uwrobotics/MarsRoverElectricalKiCad/README.md

# Getting Started

Please follow the following step to create a project from template, step by step and complete the project
