uwrobotics/MarsRoverElectricalKiCad/projects/LM5143_Buck/LM5143_BOM.xlsx

Part/Label | Value | Qty. | Price (USD or CAD) | Sum (CAD) | Link
Buck Controller |  |  |  |  |  |  | USD to CAD Conversion Rate | 1.37
LM5143QRHARQ1 |  | 1 | 3.72 | 5.10 | https://www.lcsc.com/product-detail/C5219258.html
Capacitor In
EKYC101ELL331MK25S | 330uF | 4 | 1.92 | 7.68 | https://www.digikey.ca/en/products/detail/chemi-con/EKYC101ELL331MK25S/26120648
CL32B475KCJZ4NE | 4.7uF | 8 | 0.69 | 5.52 | https://www.digikey.ca/en/products/detail/samsung-electro-mechanics/CL32B475KCJZ4NE/27519552
CL10B104KC8NNNC | 100nF | 0.32 | 0.33 | 0.14 | https://www.lcsc.com/product-detail/C15725.html | *16 out of 50
CL10B103KC8NNNC | 10nF | 0.05 | 0.63 | 0.04 | https://www.lcsc.com/product-detail/C84709.html | *5 out of 100
Capacitor Out
RPF0811101M050K | 100uF | 2 | 1.46 | 2.92 | https://www.digikey.ca/en/products/detail/kyocera-avx/RPF0811101M050K/20096773
CL32B106KBJNNNE | 10uF | 5 | 0.17 | 1.16 | https://www.lcsc.com/product-detail/C138687.html
CL10B104KC8NNNC | 100nF | Tallied Above (2x)
GanFET + Driver
IGC025S08S1XTMA1 |  | 4 | 6.62 | 26.48 | https://www.digikey.ca/en/products/detail/infineon-technologies/IGC025S08S1XTMA1/25902269
LM5113QDPRRQ1 |  | 2 | 6.79 | 13.58 | https://www.digikey.ca/en/products/detail/texas-instruments/LM5113QDPRRQ1/7034938
RC0603FR-071KL | 1k | 0.04 | 0.13 | 0.01 | https://www.lcsc.com/product-detail/C22548.html | *4 out of 100
CL10C220JB8NNNC | 22pF | 0.04 | 0.45 | 0.02 | https://www.lcsc.com/product-detail/C1653.html | *4 out of 100
CL10B105KA8NNNC | 1uF | 0.12 | 0.32 | 0.05 | https://www.lcsc.com/product-detail/C29936.html | *6 out of 50
BAT46JFILM |  | 0.4 | 0.71 | 0.39 | https://www.lcsc.com/product-detail/C111205.html | *4 out of 10
RC0603FR-07100RL | 100 | 0.02 | 0.13 | 0.003562 | https://www.lcsc.com/product-detail/C105588.html | *2 out of 100
CL10B104KC8NNNC | 100nF | Tallied Above (2x)
RC0603FR-070RL | 0 | 0.08 | 0.12 | 0.01 | https://www.lcsc.com/product-detail/C95177.html | *8 out of 100
LDOs
AP7387-50FDC-7 |  | 1 | 0.75 | 0.75 | https://www.digikey.ca/en/products/detail/diodes-incorporated/AP7387-50FDC-7/17874785
CL10B105KA8NNNC | 1uF | Tallied Above (3x)
CL32B106KBJNNNE | 10uF | Tallied Above (1x)
TLV74033PDBVR |  | 0.1 | 0.51 | 0.07 | https://www.lcsc.com/product-detail/C3743587.html | *1 out of 10
RT0603FRE0710KL | 10k | 0.04 | 0.52 | 0.03 | https://www.lcsc.com/product-detail/C469659.html | *2 out of 50
Inductor
CPQ2620H-100M | 10uH | 2 | 2.99 | 8.19 | https://www.lcsc.com/product-detail/C41347719.html
Shunt Resistors
ASR-K-3-2.2F | 2.2m | 0.4 | 1.35 | 0.74 | https://www.lcsc.com/product-detail/C6075476.html | *2 out of 5
PCSR2512BR005M6 | 5m | 4 | 3.13 | 17.15 | https://www.lcsc.com/product-detail/C48982662.html
Heat Sink
HSB35-272725 |  | 1 | 2.95 | 2.95 | https://www.digikey.ca/en/products/detail/same-sky-formerly-cui-devices/HSB35-272725/22535724
Heat Sink Tape |  | 0.01 | 6.94 | 0.07 | https://www.digikey.ca/en/products/detail/adafruit-industries-llc/1468/7241459
Compensation
RT0603FRE0712KL | 12k | 0.02 | 0.52 | 0.01 | https://www.lcsc.com/product-detail/C136933.html | *1 out of 50
GRM1885C1H562JA01D | 5.6nF | 0.02 | 0.74 | 0.02 | https://www.lcsc.com/product-detail/C440183.html | *1 out of 50
CL10C121JB8NNNC | 120pF | 0.02 | 0.55 | 0.02 | https://www.lcsc.com/product-detail/C18438.html | *1 out of 50
Others
CL10B104KC8NNNC | 100nF | Tallied Above (3x)
CL21B225KAFNNNE | 2.2uF | 0.3 | 0.15 | 0.06 | https://www.lcsc.com/product-detail/C19110.html | *3 out of 10
CL10B474KA8NNNC | 470nF | 0.02 | 0.71 | 0.02 | https://www.lcsc.com/product-detail/C1623.html | *2 out of 100
CL10B103KC8NNNC | 10nF | Tallied Above (1x)
RT0603FRE07100KL | 100k | 0.02 | 0.55 | 0.02 | https://www.lcsc.com/product-detail/C728638.html | *1 out of 50
RT0603FRE07390KL | 390k | 0.02 | 0.54 | 0.01 | https://www.lcsc.com/product-detail/C863775.html | *1 out of 50
RT0603FRE0710KL | 10k | Tallied Above (1x)
B18W1NG--20C000114U1930 |  | 1 | 0.23 | 0.23 | https://www.digikey.ca/en/products/detail/harvatek-corporation/B18W1NG-20C000114U1930/13588743
RT0603FRE073K3L | 3.3k | 0.08 | 0.52 | 0.06 | https://www.lcsc.com/product-detail/C863782.html | *4 out of 50
RH-5001 |  | 0.8 | 0.39 | 0.43 | https://www.lcsc.com/product-detail/C5199801.html | *4 out of 5
Telemetry
INA226AIDGSR |  | 1 | 0.67 | 0.92 | https://www.lcsc.com/product-detail/C49851.html
CL10B105KA8NNNC | 1uF | Tallied Above (1x)
RT0603FRE073K3L | 3.3k | Tallied Above (3x)
RT0603BRD0710RL | 10 | 0.4 | 0.94 | 0.52 | https://www.lcsc.com/product-detail/C861082.html | *8 out of 20
CL10B104KC8NNNC | 100nF | Tallied Above (1x)
Switch
SLW-1478144-5A-S-D |  | 2 | 0.68 | 1.36 | https://www.digikey.ca/en/products/detail/same-sky-formerly-cui-devices/SLW-1478144-5A-S-D/24399221
SLW-865144-2A-N-SMT-TR |  | 2 | 0.81 | 1.62 | https://www.digikey.ca/en/products/detail/same-sky-formerly-cui-devices/SLW-865144-2A-N-SMT-TR/24399296
Connectors
XT60PW-M |  | 1 | 0.47 | 0.64 | https://www.lcsc.com/product-detail/C98732.html
XT60PW-F |  | 1 | 0.50 | 0.69 | https://www.lcsc.com/product-detail/C428722.html
SM04B-GHS-TB |  | 0.4 | 1.27 | 0.70 | https://www.lcsc.com/product-detail/C189895.html | *2 out of 5
 |  |  | Total Cost: | 100.38
