uwrobotics/MarsRoverElectricalKiCad/projects/LM5143_Buck/LM5143_Buck.kicad_pcb

## KiCad design projects/LM5143_Buck/LM5143_Buck.kicad_pcb (2026-03-19)

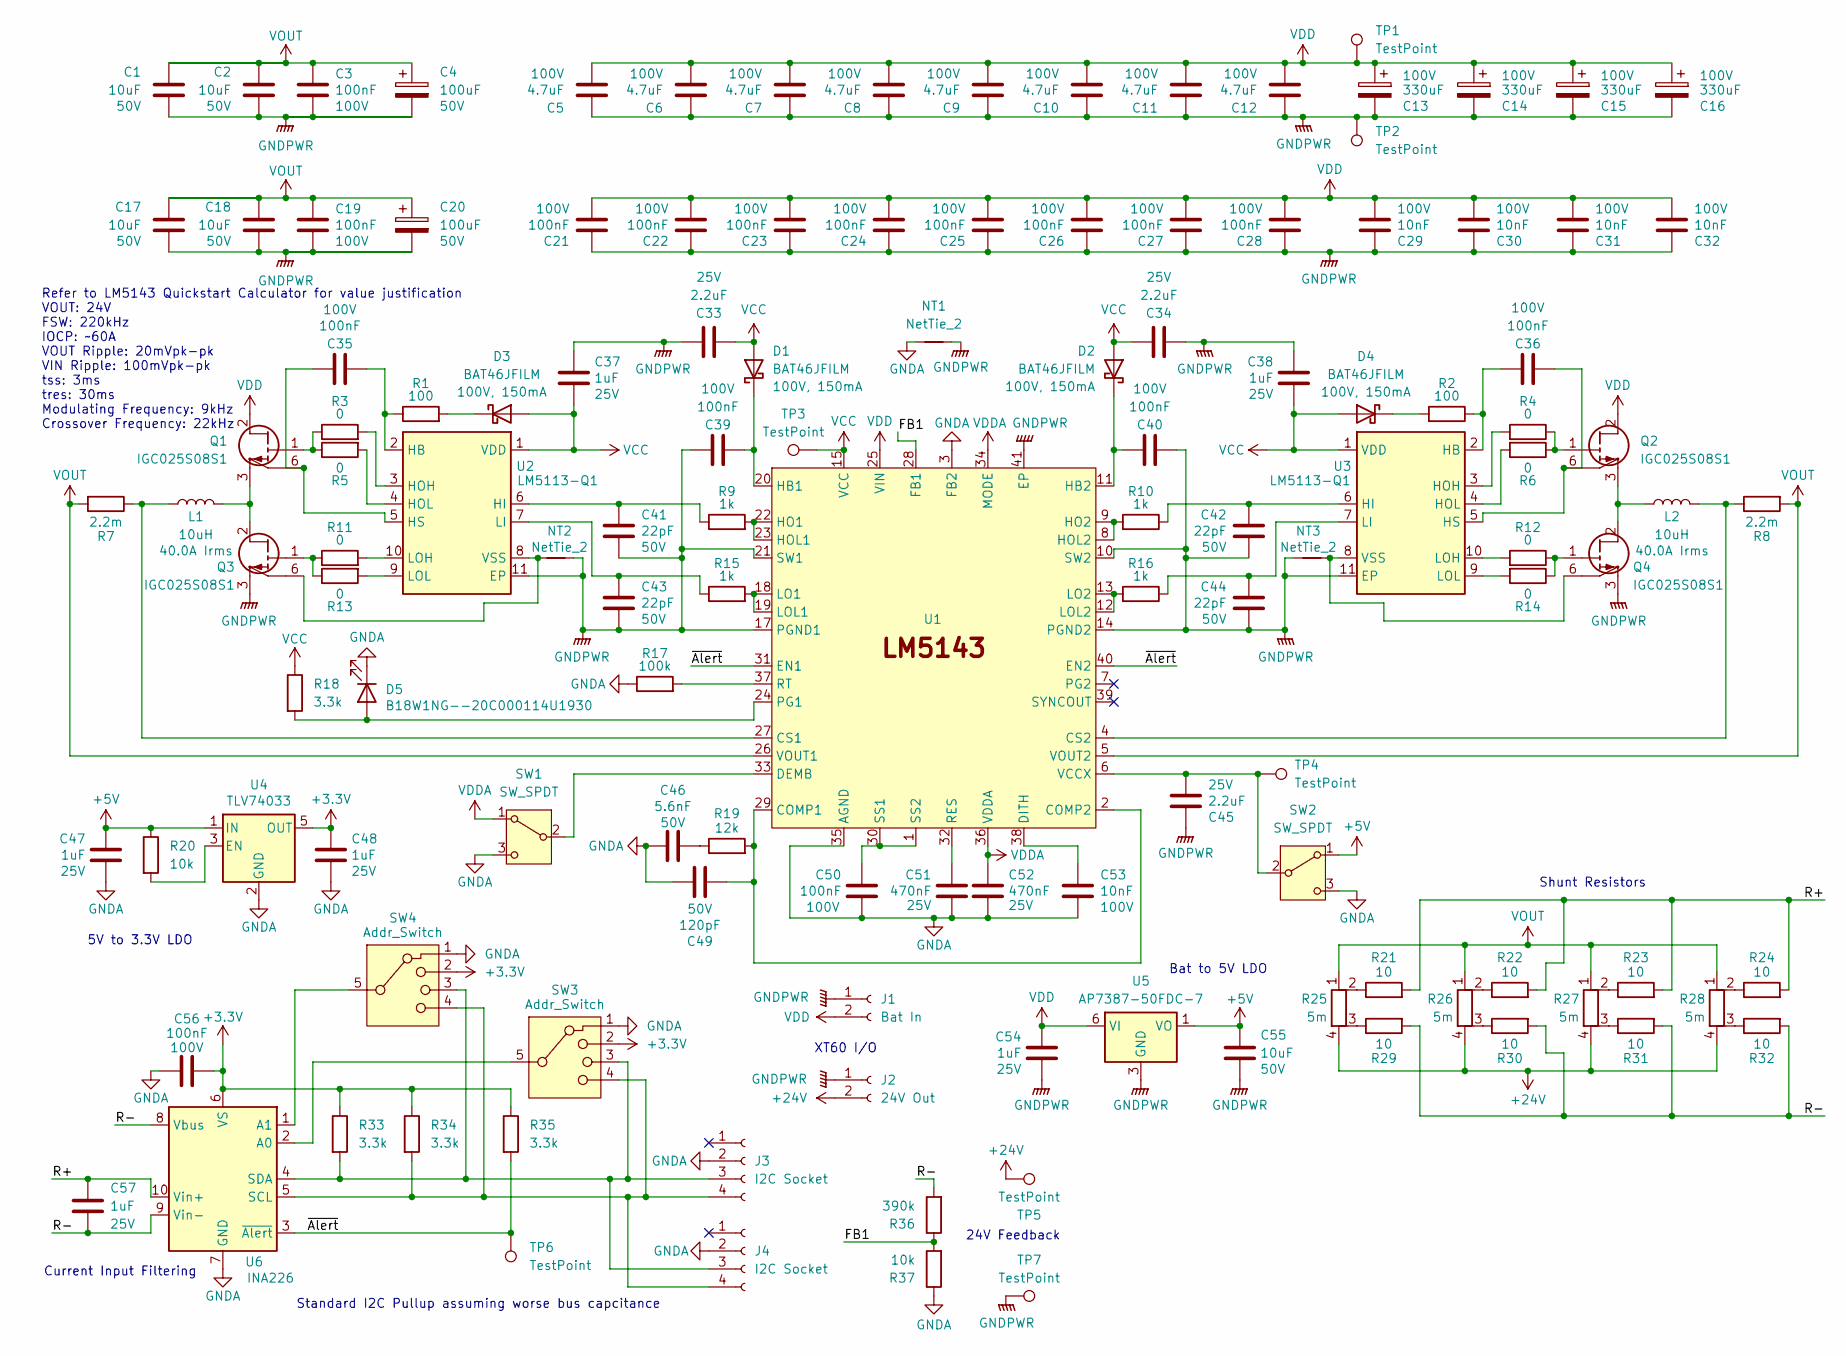
[picture p1: schematic LM5143_Buck.kicad_sch, LM5143 Buck]

Parts:
C1, C2, C17, C18, C55: 10uF; C_1210_3225Metric; Voltage 50V
C3, C19, C21, C22, C23, C24, C25, C26, C27, C28, C35, C36, C39, C40, C50, C56: 100nF; C_0603_1608Metric; Voltage 100V
C4, C20: 100uF; CP_Radial_D8.0mm_P3.50mm; Voltage 50V
C5, C6, C7, C8, C9, C10, C11, C12: 4.7uF; C_1210_3225Metric; Voltage 100V
C13, C14, C15, C16: 330uF; CP_Radial_D12.5mm_P5.00mm; Voltage 100V
C29, C30, C31, C32, C53: 10nF; C_0603_1608Metric; Voltage 100V
C33, C34, C45: 2.2uF; C_0805_2012Metric; Voltage 25V
C37, C38, C47, C48, C54, C57: 1uF; C_0603_1608Metric; Voltage 25V
C41, C42, C43, C44: 22pF; C_0603_1608Metric; Voltage 50V
C46: 5.6nF; C_0603_1608Metric; Voltage 50V
C49: 120pF; C_0603_1608Metric; Voltage 50V
C51, C52: 470nF; C_0603_1608Metric; Voltage 25V
D1, D2, D3, D4: BAT46JFILM; D_SOD-323_Alt
D5: B18W1NG--20C000114U1930; LED_0603_1608Metric
J1: Bat In; XT60PW
J2: 24V Out; XT60PW
J3, J4: I2C Socket; JST_GH_SM04B-GHS-TB_1x04-1MP_P1.25mm_Horizontal
L1, L2: 10uH; CPQ2620H
NT1, NT2, NT3: NetTie_2; NetTie-2_SMD_Pad0.25mm
Q1, Q2, Q3, Q4: IGC025S08S1; PG‑TSON‑6
R1, R2: 100; R_0603_1608Metric
R3, R4, R5, R6, R11, R12, R13, R14: 0; R_0603_1608Metric
R7, R8: 2.2m; ASR2512
R9, R10, R15, R16: 1k; R_0603_1608Metric
R17: 100k; R_0603_1608Metric
R18, R33, R34, R35: 3.3k; R_0603_1608Metric
R19: 12k; R_0603_1608Metric
R20, R37: 10k; R_0603_1608Metric
R21, R22, R23, R24, R29, R30, R31, R32: 10; R_0603_1608Metric
R25, R26, R27, R28: 5m; PCSR2512
R36: 390k; R_0603_1608Metric
SW1, SW2: SW_SPDT; SLW-865144-2A-N-SMT-TR
SW3, SW4: Addr_Switch; SLW-1478144-5A-S-D
TP1, TP2, TP5, TP7: TestPoint; TestPoint_Keystone_5000-5004_Miniature
TP3, TP4, TP6: TestPoint; TestPoint_Pad_D2.0mm
U1: Texas_VQFN-40-1EP_6x6mm_P0.5mm_EP3.3x3.3mm_ThermalVias
U2, U3: LM5113-Q1; WSON-10-1EP_4x4mm_P0.8mm_EP2.6x3mm_ThermalVias
U4: TLV74033; SOT-23-5
U5: AP7387-50FDC-7; DFN-6-1EP_2x2mm_P0.65mm_EP1.01x1.7mm
U6: INA226; VSSOP-10_3x3mm_P0.5mm

Connections:
+3.3V: C48.1, C56.2, R33.1, R34.1, R35.1, SW3.2, SW4.2, U4.5 (OUT), U6.6 (VS)
+5V: C47.1, C55.1, R20.1, SW2.1 (A), U4.1 (IN), U5.1 (VO)
+24V: J2.2, R25.4, R26.4, R27.4, R28.4, TP5.1
/FB1: R36.1, R37.2, U1.28 (FB1)
/R+: C57.1, R21.2, R22.2, R23.2, R24.2, U6.10 (Vin+)
/R-: C57.2, R29.2, R30.2, R31.2, R32.2, R36.2, U6.8 (Vbus), U6.9 (Vin-)
/~Alert: R35.2, TP6.1, U1.31 (EN1), U1.40 (EN2), U6.3 (~Alert)
GNDA: C46.1, C47.2, C48.2, C49.1, C50.2, C51.2, C52.2, C53.2, C56.1, D5.1 (K), J3.2, J4.2, NT1.1, R17.1, R37.1, SW1.3 (C), SW2.3 (C), SW3.1, SW4.1, U1.3 (FB2), U1.35 (AGND), U4.2 (GND), U6.7 (GND)
GNDPWR: C1.2, C2.2, C3.2, C4.2, C5.1, C6.1, C7.1, C8.1, C9.1, C10.1, C11.1, C12.1, C13.2, C14.2, C15.2, C16.2, C17.2, C18.2, C19.2, C20.2, C21.1, C22.1, C23.1, C24.1, C25.1, C26.1, C27.1, C28.1, C29.1, C30.1, C31.1, C32.1, C33.1, C34.1, C37.1, C38.1, C39.1, C40.1, C41.2, C42.2, C43.2, C44.2, C45.1, C54.2, C55.2, J1.1, J2.1, NT1.2, NT2.2, NT3.2, Q3.3 (S), Q3.5 (S), Q4.3 (S), Q4.5 (S), TP2.1, TP7.1, U1.10 (SW2), U1.14 (PGND2), U1.17 (PGND1), U1.21 (SW1), U1.41 (EP), U2.11 (EP), U3.11 (EP), U5.2 (GND), U5.3 (GND), U5.4 (GND), U5.5 (GND), U5.7 (GND)
unnamed: C46.2, R19.1
unnamed: C39.2, D1.1 (K), U1.20 (HB1)
unnamed: C40.2, D2.1 (K), U1.11 (HB2)
unnamed: D3.1 (K), R1.2
unnamed: D4.1 (K), R2.2
unnamed: D5.2 (A), R18.2, U1.24 (PG1)
unnamed: J3.3, J4.3, R33.2, SW3.3, SW4.3, U6.4 (SDA)
unnamed: J3.4, J4.4, R34.2, SW3.4, SW4.4, U6.5 (SCL)
unnamed: L1.2, Q1.3 (S), Q1.5 (S), Q3.2 (D), Q3.4 (D)
unnamed: L2.1, Q2.3 (S), Q2.5 (S), Q4.2 (D), Q4.4 (D)
unnamed: Q1.1 (G), R3.1, R5.1
unnamed: C35.1, Q1.6 (SS), U2.5 (HS)
unnamed: Q2.1 (G), R4.1, R6.1
unnamed: C36.1, Q2.6 (SS), U3.5 (HS)
unnamed: Q3.1 (G), R11.1, R13.1
unnamed: NT2.1, Q3.6 (SS), U2.8 (VSS)
unnamed: Q4.1 (G), R12.1, R14.1
unnamed: NT3.1, Q4.6 (SS), U3.8 (VSS)
unnamed: R21.1, R25.2
unnamed: R22.1, R26.2
unnamed: R23.1, R27.2
unnamed: R24.1, R28.2
unnamed: R25.3, R29.1
unnamed: R26.3, R30.1
unnamed: R27.3, R31.1
unnamed: R28.3, R32.1
unnamed: SW1.2 (B), U1.33 (DEMB)
unnamed: C45.2, SW2.2 (B), TP4.1, U1.6 (VCCX)
unnamed: C49.2, R19.2, U1.2 (COMP2), U1.29 (COMP1)
unnamed: L1.1, R7.1, U1.27 (CS1)
unnamed: L2.2, R8.1, U1.4 (CS2)
unnamed: C53.1, U1.38 (DITH)
unnamed: R9.2, U1.22 (HO1), U1.23 (HOL1)
unnamed: R10.2, U1.8 (HOL2), U1.9 (HO2)
unnamed: R15.2, U1.18 (LO1), U1.19 (LOL1)
unnamed: R16.2, U1.12 (LOL2), U1.13 (LO2)
unnamed: C51.1, U1.32 (RES)
unnamed: R17.2, U1.37 (RT)
unnamed: C50.1, U1.1 (SS2), U1.30 (SS1)
unnamed: C35.2, R1.1, U2.2 (HB)
unnamed: C41.1, R9.1, U2.6 (HI)
unnamed: R3.2, U2.3 (HOH)
unnamed: R5.2, U2.4 (HOL)
unnamed: C43.1, R15.1, U2.7 (LI)
unnamed: R11.2, U2.10 (LOH)
unnamed: R13.2, U2.9 (LOL)
unnamed: C36.2, R2.1, U3.2 (HB)
unnamed: C42.1, R10.1, U3.6 (HI)
unnamed: R4.2, U3.3 (HOH)
unnamed: R6.2, U3.4 (HOL)
unnamed: C44.1, R16.1, U3.7 (LI)
unnamed: R12.2, U3.10 (LOH)
unnamed: R14.2, U3.9 (LOL)
unnamed: R20.2, U4.3 (EN)
unnamed: SW3.5, U6.2 (A0)
unnamed: SW4.5, U6.1 (A1)
VCC: C33.2, C34.2, C37.2, C38.2, D1.2 (A), D2.2 (A), D3.2 (A), D4.2 (A), R18.1, TP3.1, U1.15 (VCC), U1.16 (VCC), U2.1 (VDD), U3.1 (VDD)
VDD: C5.2, C6.2, C7.2, C8.2, C9.2, C10.2, C11.2, C12.2, C13.1, C14.1, C15.1, C16.1, C21.2, C22.2, C23.2, C24.2, C25.2, C26.2, C27.2, C28.2, C29.2, C30.2, C31.2, C32.2, C54.1, J1.2, Q1.2 (D), Q1.4 (D), Q2.2 (D), Q2.4 (D), TP1.1, U1.25 (VIN), U5.6 (VI)
VDDA: C52.1, SW1.1 (A), U1.34 (MODE), U1.36 (VDDA)
VOUT: C1.1, C2.1, C3.1, C4.1, C17.1, C18.1, C19.1, C20.1, R7.2, R8.2, R25.1, R26.1, R27.1, R28.1, U1.5 (VOUT2), U1.26 (VOUT1)

Notes on the sheet:
24V Feedback
Bat to 5V LDO
Refer to LM5143 Quickstart Calculator for value justification VOUT: 24V FSW: 220kHz IOCP: ~60A VOUT Ripple: 20mVpk-pk VIN Ripple: 100mVpk-pk tss: 3ms tres: 30ms Modulating Frequency: 9kHz Crossover Frequency: 22kHz
XT60 I/O
5V to 3.3V LDO
Current Input Filtering
Shunt Resistors
Standard I2C Pullup assuming worse bus capcitance

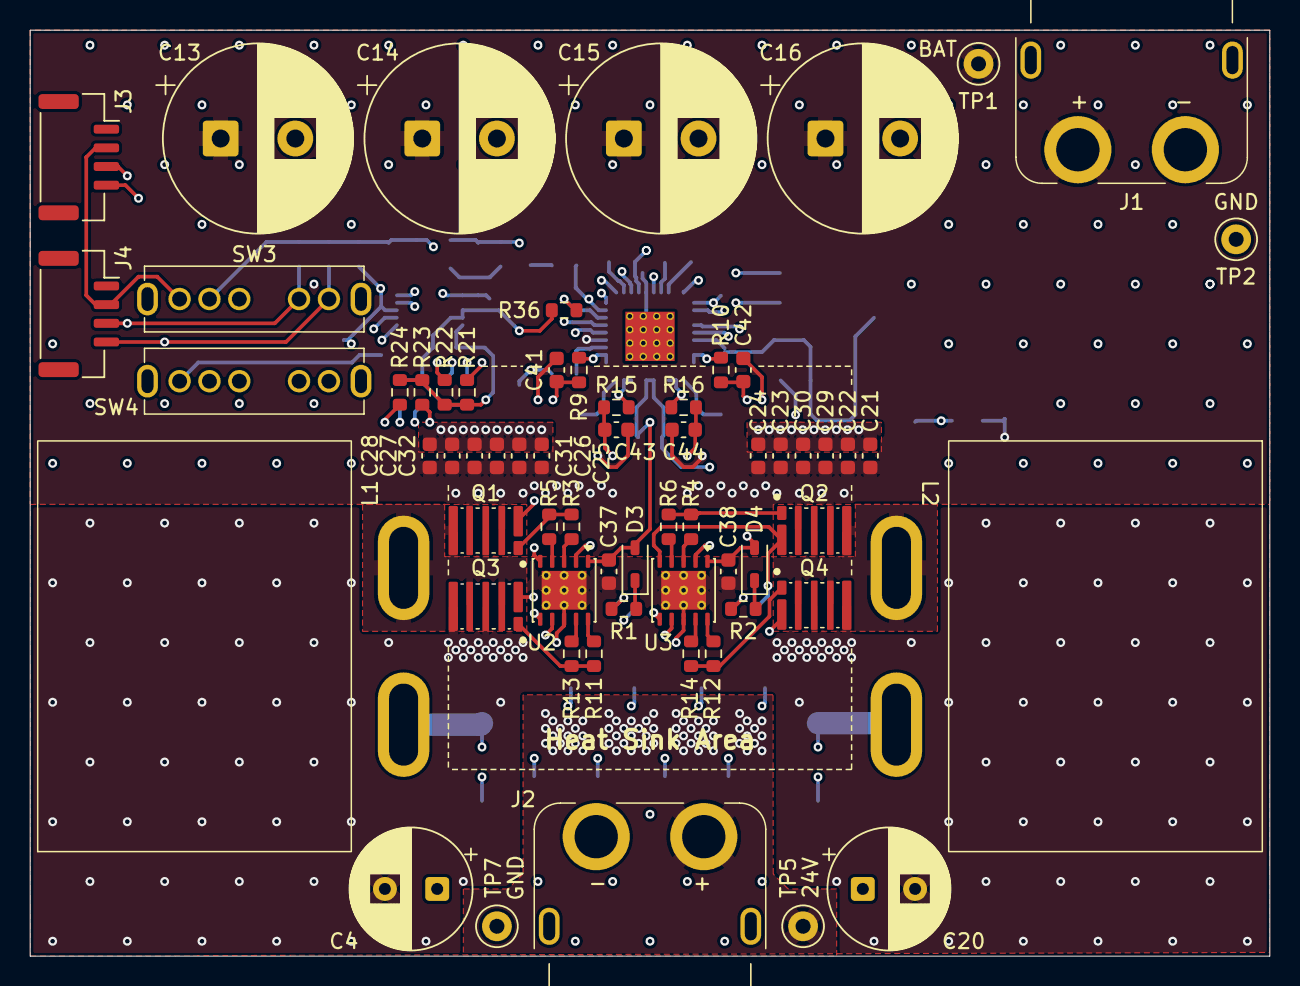
[picture p2: board LM5143_Buck.kicad_pcb from above]

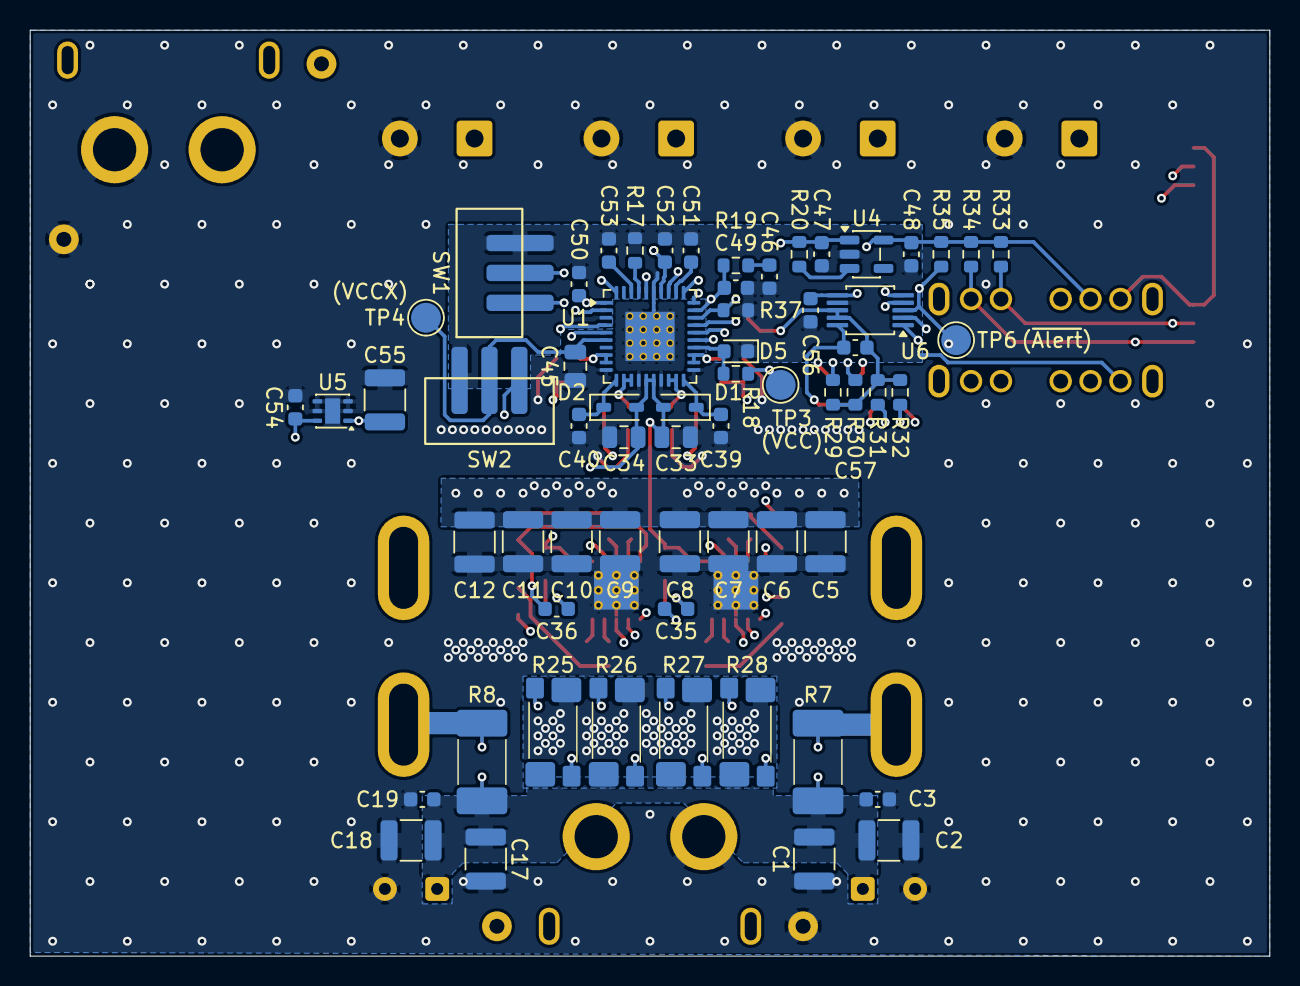
[picture p3: board LM5143_Buck.kicad_pcb from below]

Board: 4 copper layers, 83.0 x 62.0 mm, 129 parts (64 on the bottom side), 69 nets.
