uwrobotics/MarsRoverElectricalKiCad/projects/LM5143_Buck/BSR066A/BSR066A.kicad_pcb

## KiCad design projects/LM5143_Buck/BSR066A/BSR066A.kicad_pcb (2026-01-29)

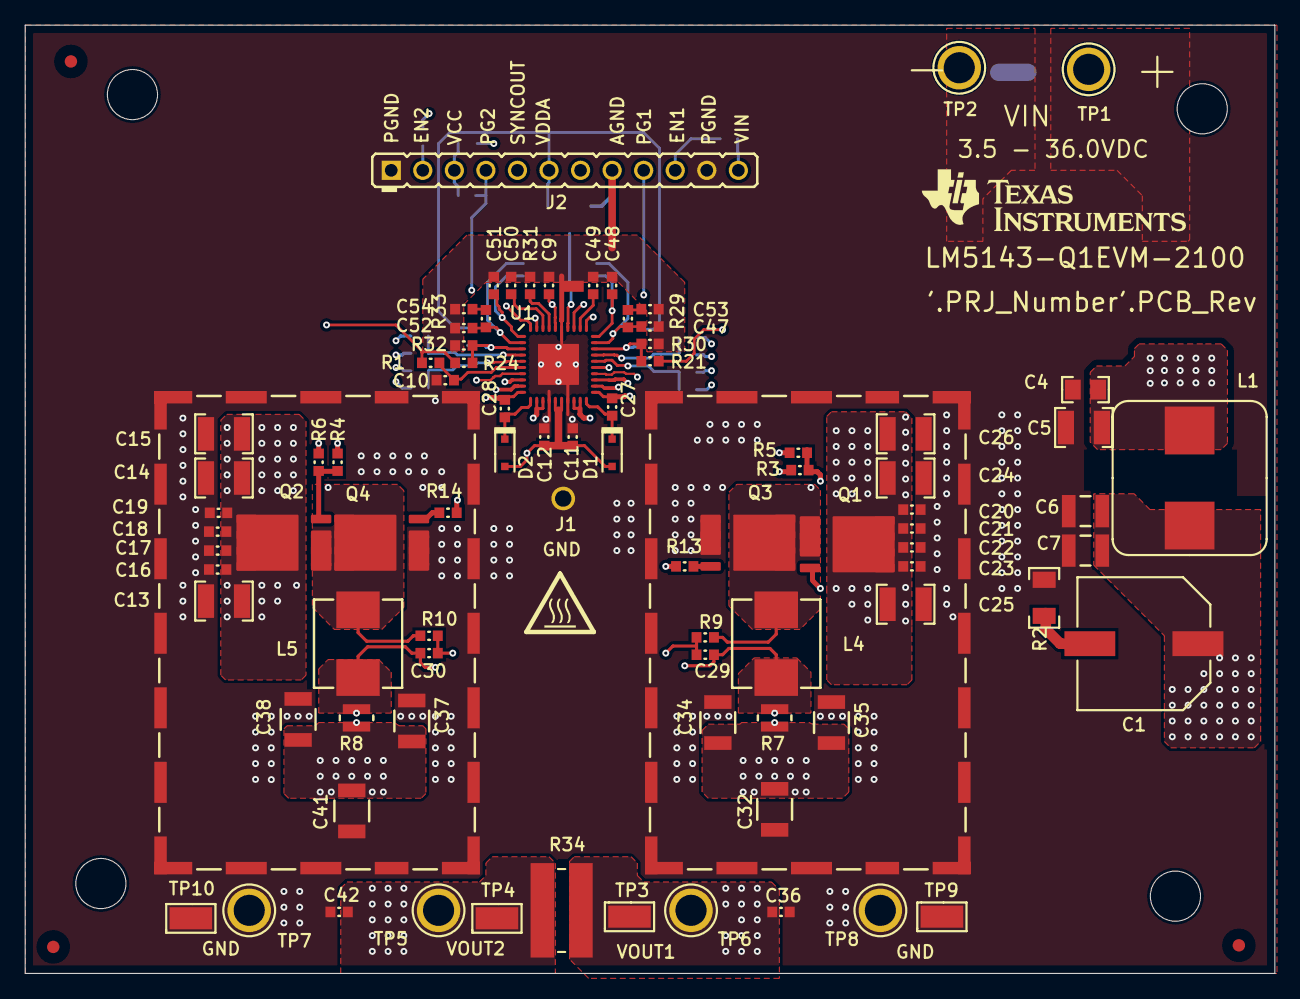
[picture p4: board BSR066A.kicad_pcb from above]

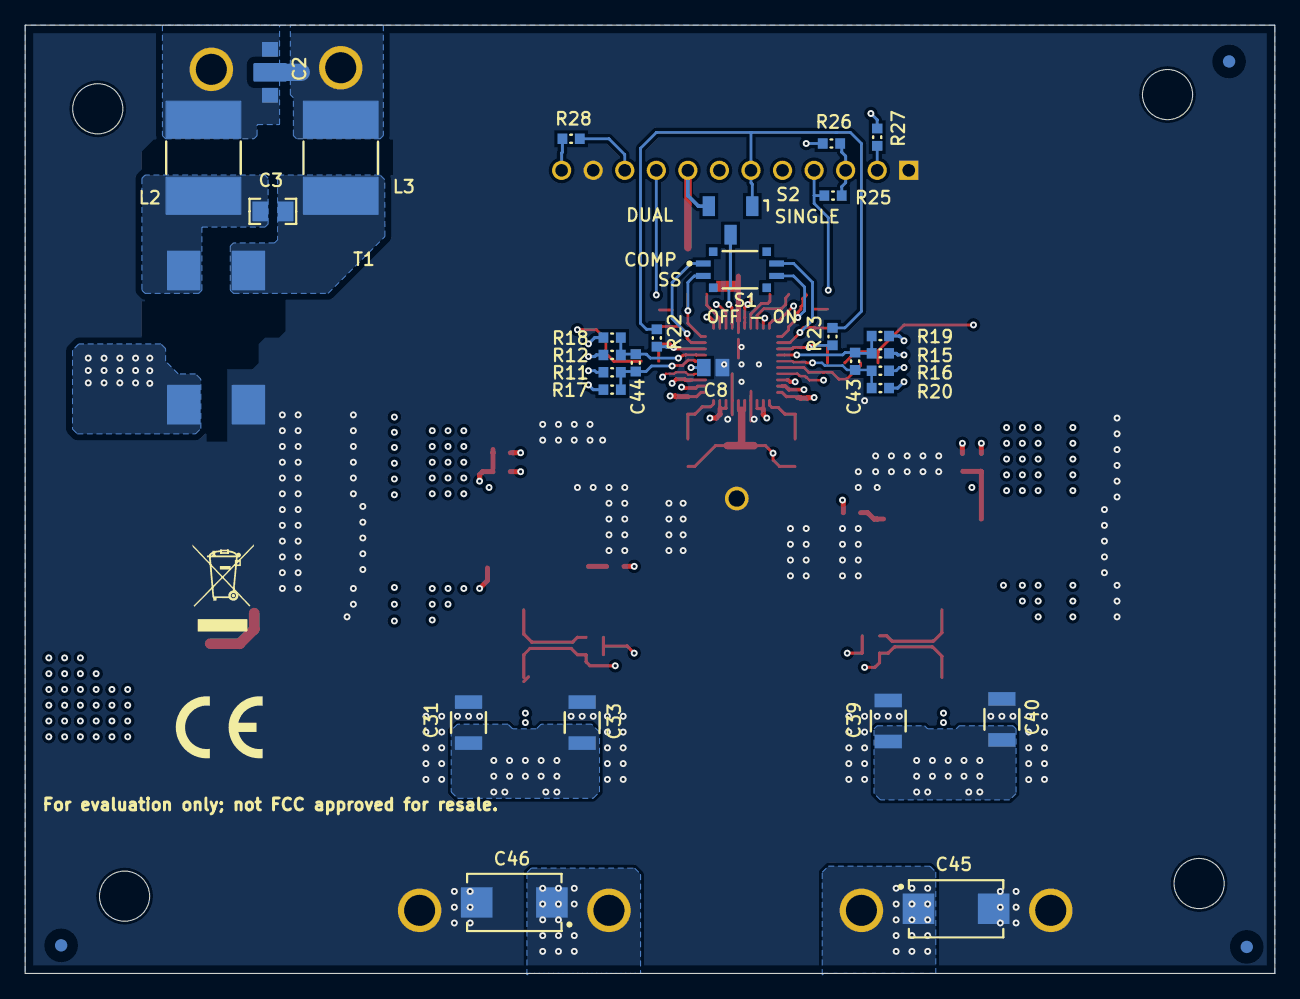
[picture p5: board BSR066A.kicad_pcb from below]

Board: 6 copper layers, 100.6 x 76.3 mm, 144 parts (40 on the bottom side), 54 nets.

Parts:
C1: EEE-FC1H470P; SM_RADIAL_G
C2: 1uF; YFF31AH2A10xM
C3, C4: C0805C104K1RACTU; 0805_HV
C5, C13, C14, C15, C24, C25, C26: UMJ325KB7106KMHT; 1210_270
C6, C7: UMJ325KB7106KMHT; 1210_270L
C8: GRM21BR72A474KA73L; 0805L
C9: GCM188R71C474KA55D; 0603L
C10, C11, C12: GRM188R71A225KE15D; 0603L
C16, C17, C18, C19, C20, C21, C22, C23, C50: GRM188R72A103KA01D; 0603L
C27, C28, C29, C30, C42, C48, C51: CGA3E2X7R1E104K080AA; 0603L
C31, C32, C33, C34, C35, C37, C38, C39, C40, C41: CGA6P1X7S0J476M250AC; 1210_280
C36: GRM188R72A104KA35D; 0603L
C43, C44: 06031A330JAT2A; 0603L
C45, C46: T598D227M010ATE025; 7343-31
C47, C52: GRM1885C1H150JA01D; 0603L
C49: CL10B224KO8VPNC; 0603L
C53, C54: C0603C102K5HACTU; 0603L
D1, D2: 60V; SOD-323F
FID1, FID2, FID3, FID4, FID5, FID6: Fiducial; Fiducial10-20
H1, H2: BMI-S-205-F; Laird_BMI-S-205-F
H3, H4, H5, H6: 1902C; Keystone_1902C
J1: 1040; CONN_1040
J2: PBC12SABN; Sullins_PxC12SABN
L1: 744325420; WE-HC6
L2, L3: 800 ohm; 2220_390
L4, L5: 744373460068; WE-LHMI_7030
LOGO2: CAUTION HOT SURFACE; IEC_HotSurface_Small
Logo1: CE Mark; CE_Mark_5mm
Logo3: Texas Instruments; TI_Stacked_Overlay_Small
Logo4: FCC disclaimer; FCC_disclaimer
Logo5: WEEE logo; WEEE_Minimum
MH1, MH2, MH3, MH4: MTG_NoPads; MTG_159mil
NT1: Net-Tie; Net-Tie_10mil
Q1, Q2, Q3, Q4: IPC50N04S5L5R5ATMA1; PG-TDSON-8-33
R1: RC0603FR-071RL; 0603L
R2: CRCW12061R00JNEA; 1206
R3, R4, R5, R6, R11, R13, R14, R16, R22, R23: CRCW06030000Z0EA; 0603L
R7, R8: KRL2012M-R007-F-T1; KRL2012
R9, R10: CRCW06031K50FKEA; 0603L
R12, R15: CRCW060349R9FKEA; 0603L
R17, R18, R19, R20: CRCW0603100RFKEA; 0603L
R21, R24, R25, R26, R27, R28: CRCW0603100KFKEA; 0603L
R29: CRCW060320K0FKEA; 0603L
R30: CRCW060322K1FKEA; 0603L
R31: RC0603FR-0710KL; 0603L
R32: CRCW060313K7FKEA; 0603L
R33: CRCW060324K9FKEA; 0603L
R34: RCL12250000Z0EG; 2512_WIDE_VISHAY
S1: CVS-02TB; SW_CVS-02B
S2: CJS-1201TA; SW_CJS_1201A
T1: ACM12V-701-2PL-TL00; TDK_ACM12V
TP1, TP2, TP5, TP6, TP7, TP8: 1598-2; Keystone1598-2
TP3, TP4, TP9, TP10: 5015; Testpoint_Keystone_Miniature
U1: LM5143QRWGRQ1; RWG0040A
ZZ1: These assemblies are ESD sensitive, ESD precautio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; AssemblyNote
ZZ2: These assemblies must be clean and free from flux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; AssemblyNote
ZZ3: These assemblies must comply with workmanship sta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; AssemblyNote
ZZ4: After final wash remove kapton tape cover from SW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; AssemblyNote
ZZ5: Set SW1 A & B to OFF position; AssemblyNote
ZZ6: Set SW2 to SINGLE position; AssemblyNote
ZZ7: Place Shunt Jumper SH-J1 onto J2 onto pins 6-7 (V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; AssemblyNote

Connections:
AGND: C9.1, C47.2, C48.2, C49.2, C50.2, C51.2, C52.2, C53.2, C54.2, J2.8, NT1.1, R30.1, R31.1, R32.1, S2.3, U1.35
COMP1: C47.1, R29.2, S1.1, U1.29
COMP2: C52.1, R33.2, S1.4, U1.2
DEMB: J2.7, U1.33
EN1: J2.10, R28.1, U1.31
EN2: J2.2, R27.1, U1.40
FB1: R21.1, R22.1, R30.2, U1.28
FB2: R23.1, R24.1, R32.2, U1.3
NetC1_2: C1.2, R2.2
NetC2_1: C2.1, C2.2, L2.1, TP1.1
NetC2_3: C2.3, L3.1, TP2.1
NetC3_1: C3.1, L3.2, T1.1
NetC3_2: C3.2, L2.2, T1.2
NetC4_1: C4.1, C5.1, L1.1, T1.3
NetC10_1: C10.1, R1.1, U1.6
NetC27_1: C27.1, L4.1, Q1.1, Q1.2, Q1.3, Q3.5, Q3.6, Q3.7, Q3.8, R9.2, U1.21
NetC27_2: C27.2, D1.1, U1.20
NetC28_1: C28.1, L5.1, Q2.1, Q2.2, Q2.3, Q4.5, Q4.6, Q4.7, Q4.8, R10.2, U1.10
NetC28_2: C28.2, D2.1, U1.11
NetC29_1: C29.1, R9.1, R18.2
NetC29_2: C29.2, L4.2, R7.1, R12.2, R17.2
NetC30_1: C30.1, R10.1, R19.2
NetC30_2: C30.2, L5.2, R8.1, R15.2, R20.2
NetC43_1: C43.1, R16.1, R20.1, U1.5
NetC43_2: C43.2, R15.1, R19.1, U1.4
NetC44_1: C44.1, R11.1, R17.1, U1.26
NetC44_2: C44.2, R12.1, R18.1, U1.27
NetC49_1: C49.1, U1.32
NetC50_1: C50.1, U1.38
NetC53_1: C53.1, R29.1
NetC54_1: C54.1, R33.1
NetQ1_4: Q1.4, R3.2, R5.2
NetQ2_4: Q2.4, R4.2, R6.2
NetQ3_4: Q3.4, R13.2
NetQ4_4: Q4.4, R14.2
NetR3_1: R3.1, U1.22
NetR4_1: R4.1, U1.9
NetR5_1: R5.1, U1.23
NetR6_1: R6.1, U1.8
NetR13_1: R13.1, U1.18, U1.19
NetR14_1: R14.1, U1.12, U1.13
NetR31_2: R31.2, U1.37
NetS2_2: S2.2, U1.34
PG1: J2.9, R26.1, U1.24
PG2: J2.4, R25.1, U1.7
PGND: C4.2, C5.2, C6.2, C7.2, C8.1, C10.2, C11.2, C12.2, C13.2, C14.2, C15.2, C16.1, C17.1, C18.1, C19.1, C20.1, C21.1, C22.1, C23.1, C24.2, C25.2, C26.2, C31.2, C32.2, C33.2, C34.2, C35.2, C36.2, C37.2, C38.2, C39.2, C40.2, C41.2, C42.2, C45.2, C46.2, H1.1, H2.1, J1.1, J2.1, J2.11, NT1.2, Q3.1, Q3.2, Q3.3, Q4.1, Q4.2, Q4.3, R2.1, T1.4, TP7.1, TP8.1, TP9.1, TP10.1, U1.14, U1.17, U1.41
SS1: C48.1, S1.2, U1.30
SS2: C51.1, S1.3, U1.1
SYNCOUT: J2.5, U1.39
VCC: C11.1, C12.1, D1.2, D2.2, J2.3, R25.2, R26.2, U1.15, U1.16
VDDA: C9.2, J2.6, R22.2, R23.2, S2.1, U1.36
VIN: C1.1, C6.1, C7.1, C8.2, C13.1, C14.1, C15.1, C16.2, C17.2, C18.2, C19.2, C20.2, C21.2, C22.2, C23.2, C24.1, C25.1, C26.1, J2.12, L1.2, Q1.5, Q1.6, Q1.7, Q1.8, Q2.5, Q2.6, Q2.7, Q2.8, R27.2, R28.2, U1.25
VOUT1: C31.1, C32.1, C33.1, C34.1, C35.1, C36.1, C46.1, R7.2, R11.2, R21.2, R34.1, TP3.1, TP6.1
VOUT2: C37.1, C38.1, C39.1, C40.1, C41.1, C42.1, C45.1, R1.2, R8.2, R16.2, R24.2, R34.2, TP4.1, TP5.1
