uwrobotics/MarsRoverElectricalKiCad/(commit log)

2026-01-29 ts will change soon
    [BSR066A.kicad_pcb, BSR066A.kicad_sch, LM5143_Buck.kicad_pcb, LM5143_Buck.kicad_sch]
2026-01-30 new schematic revision
    [LM5143-200k.xlsm, LM5143_BOM.xlsx, LM5143_Buck.kicad_sch]
2026-02-04 PCB wiring
    [LM5143_Buck.kicad_pcb, LM5143_Buck.kicad_sch]
2026-02-04 Update stuff
    [LM5143_Buck.kicad_pcb, LM5143_Buck.kicad_sch]
2026-02-04 minor fixes
    [LM5143_BOM.xlsx, LM5143_Buck.kicad_pcb]
2026-02-05 Minor changes
    [LM5143_BOM.xlsx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]
2026-02-12 Changed a few pad sizes
    [LM5143_Buck.kicad_pcb, LM5143_Buck.kicad_sch]
2026-02-15 update component link
    [LM5143_BOM.xlsx]
2026-02-18 Change switch orientation, update XT60 name
    [LM5143_Buck.kicad_pcb, LM5143_Buck.kicad_sch]
2026-03-02 New debug branch
    [LM5143_Buck-B_Cu.gbr, LM5143_Buck-B_Mask.gbr, LM5143_Buck-B_Paste.gbr, LM5143_Buck-B_Silkscreen.gbr, LM5143_Buck-Edge_Cuts.gbr, LM5143_Buck-F_Cu.gbr, LM5143_Buck-F_Mask.gbr, LM5143_Buck-F_Paste.gbr]
2026-03-10 New Schematic
    [LM5143-200k.xlsm, LM5143_BOM.xlsx, LM5143_Buck.kicad_pcb, LM5143_Buck.kicad_sch]
2026-03-13 Schematic update and partial routing
    [LM5143_BOM.xlsx, LM5143_Buck.kicad_pcb, LM5143_Buck.kicad_sch]
2026-03-16 Fully routed, no via stitching yet
    [LM5143_BOM.xlsx, LM5143_Buck.kicad_pcb, LM5143_Buck.kicad_sch]
2026-03-18 Added more capacitors
    [LM5143-200k.xlsm, LM5143_BOM.xlsx, LM5143_Buck.kicad_pcb, LM5143_Buck.kicad_sch]
2026-03-19 Add via stitching
    [LM5143_Buck.kicad_pcb, LM5143_Buck.kicad_sch]
2026-03-19 Edit BOM
    [LM5143_BOM.xlsx]
2026-03-20 Minor BOM fix
    [LM5143_BOM.xlsx]
